roobituk/Blaze/README.md

=========================
Blaze and Blaze IoT/IoT-X
=========================
<p align="center">
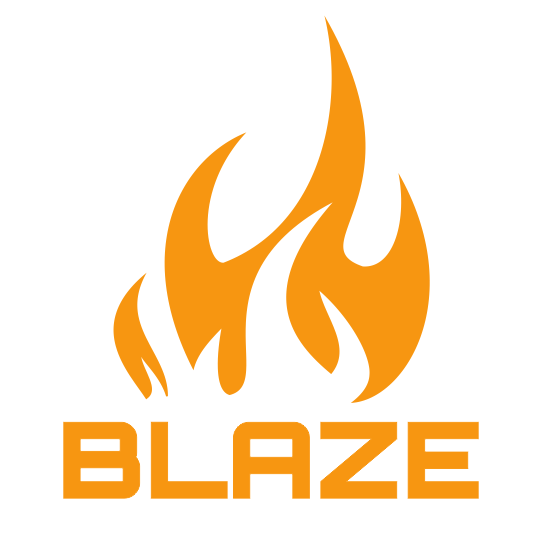
[picture p1: Logos/logo.png]
Blaze Logo
  
</p>

This is the Blaze GitHub repository.

Blaze is very much in the beta stage and is subject to significant changes of the
current code-base and API.

Important components in the Blaze repository:
- Firmware		-- The embedded software running on Blaze
- Hardware		-- Information relating to all Blaze hardware
- Software		-- Software packages and utilities for Blaze
