roobituk/Blaze/Firmware/README.md

=========================
Blaze Firmware
=========================

This is the home for the Blaze firmware.

- Blaze API				-- Contains the C++ API for working with the on-board hardware and peripheral set
- Examples
- Examples/BS			-- Blaze Studio example projects
- Examples/KDS			-- Kinetis Design Studio example projects
