roobituk/Blaze/Firmware/Drivers/README.md

=========================
Blaze Bootloader Drivers
=========================

The CDC.inf file is the Windows driver for the Blaze Bootloader device.

Refer to the cdc.inf_readme.txt for more information and installation instructions.
