roobituk/Blaze/Firmware/Arduino/blaze/ReadMe.txt

==================
BLAZE ARDUINO CORE
==================

Version 0.01a

This is a very early release of the Blaze core for Arduino IDE
