roobituk/Blaze/Firmware/Examples/Arduino/README.md

=========================
Blaze Arduino Examples
=========================

Example sketches for use with Arduino IDE.

Download the Arduino IDE from here:

https://www.arduino.cc/en/main/software

To download any of the Arduino examples to Blaze:

1) Install the Arduino IDE environment<br/>
2) Install the Arduino Blaze Support package<br/>
3) Create a new Sketch<br/>
4) Ensure that the "Blaze" option is selected for "Board" under the "Tools" menu<br/>
5) Verify your Sketch as with usual Arduino applications<br/>
6) Ensure that Blaze is connected via USB and in Bootloader Mode<br/>
7) Upload the Sketch to Blaze using the "Upload" button from the Arduino toolbar
