roobituk/Blaze/Firmware/Examples/Arduino/1. Hello World/README.md

=========================
Blaze Arduino Examples
=========================

#1 Hello World

Displays a simple "hello world" message onto the Blaze display. 

This example is useful because it contains
all of the routines required to start up the microcontroller as well as initializing the TFT display and
its associated peripherals.
