roobituk/Blaze/Firmware/Examples/Arduino/2. Touch Screen/README.md

=========================
Blaze Arduino Examples
=========================

#2 Touch Screen

Uses the touch screen controller to draw a trail beneath the users finger. 

This example demonstrates how to read touch data from the touch controller as well as being
able to draw to a specific location on the display.
