roobituk/Blaze/Firmware/Examples/Arduino/3. Digital/README.md

=========================
Blaze Arduino Examples
=========================

#3 Digital

Toggles and reads various digital IO pins.

This example demonstrates how to use the Arduino API with Blaze to write and read digital IO pins as well
as configure input pins as interrupt sources.
