roobituk/Blaze/Firmware/Examples/Arduino/4. Analog/README.md

=========================
Blaze Arduino Examples
=========================

#4 Analog

Reads from an analog input and writes to the DAC output.

This example demonstrates how to use the Arduino API with Blaze to read an analog value from an ADC as well
as write a digital value to the DAC.
