roobituk/Blaze/Firmware/Examples/Arduino/5. Draw Image/README.md

=========================
Blaze Arduino Examples
=========================

#5 Draw Image

Draws an imported bitmap image onto the display.

The image is converted from a native image format (such as a bmp, png, etc) into a suitable
binary format before being turned into C code by a 3rd party utility.
