roobituk/Blaze/Firmware/Examples/KDS/4. USB/Bitmaps/Earth.jpg

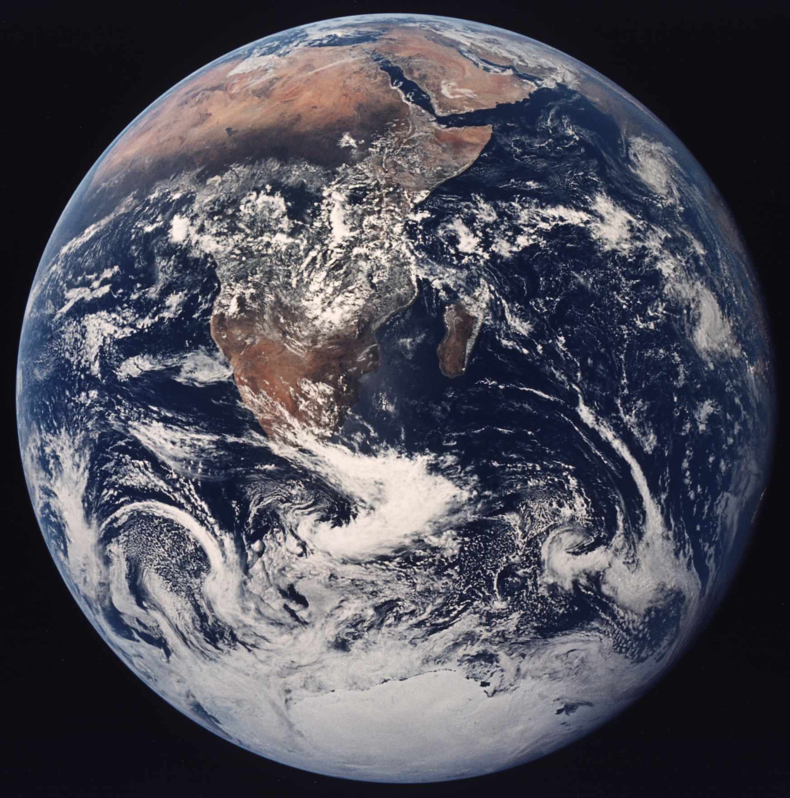
Firmware/Examples/KDS/4. USB/Bitmaps/Earth.jpg
