roobituk/Blaze/Hardware/Blaze_IoT_V1/Bill of Materials.xls

Designator | Description | Comment | Quantity
C1 | CAP CER 10uF 10V X5R 20% 0603 | 10uF/10V | 1
C2, C3, C4, C5, C17 | CAP CER 100nF 16V X7R 10% 0603 | 100nF/16V | 5
C18, C19 | CAP CER 4.7uF 16V X5R 10% 0603 | 4.7uF/16V | 2
FET1, FET2 | MOSFET P-CH 30V 0.61A SOT-23 | IRLML5103PBF | 2
J1, J2 | CON HDR 2.54mm 14POS 1ROW | MC34735 | 2
J3 | CON HDR 2.54mm 2POS 1ROW | S2B-PH-SM4-TB(LF)(SN) | 1
J4 | CON HDR 2.54mm 3POS 1ROW | S3B-PH-SM4-TB(LF)(SN) | 1
MOD1 | MOD WI-FI SMD | ESP-03 | 1
MOD2 | MOD BLUETOOTH 4.0 SMD | HM-11 | 1
R1, R2 | RES 1K 1% 0603 | 1K | 2
R5 | RES 39K 1% 0603 | 39K | 1
R6 | RES 62K 1% 0603 | 62K | 1
R7, R8 | RES 0R 1% 0603 | 0R | 2
R9, R10 | RES 10K 1% 0603 | 10K | 2
R11 | RES 2k 1% 0603 | 2K | 1
U1 | IC IMU ACC MAG GYRO LGA-24L | LSM9DS1 | 1
U6 | IC MUX QUAD 4BIT 1:2 FET QFN-16 | SN74CBTLV3257RSVR | 1
U7 | IC LI-ION CHARGE CTRL SOT23-5 | MCP73832T-2ACI/OT | 1
 |  |  | 28
