roobituk/Blaze/Hardware/Blaze_IoTX_V1/Bill of Materials.xls

Designator | Description | Comment | Quantity
ANT1 | ANT CHIP GPS GLONASS 1.5x3.0mm | ACA-106-T | 1
C1 | CAP CER 10uF 10V X5R 20% 0603 | 10uF/10V | 1
C2, C3, C4, C5, C17 | CAP CER 100nF 16V X7R 10% 0603 | 100nF/16V | 5
C6 | CAP CER 33nF 50V X7R 10% 0402 | 33nF/50V | 1
C7 | CAP CER 39pF 50V C0G NP0 5% 0402 | 39pF/50V | 1
C8 | CAP CER 470pF 50V X7R 10% 0402 | 470pF/50V | 1
C9 | CAP CER 100pF 50V C0G NP0 5% 0603 | 100pF/50V | 1
C10, C11 | CAP CER 100nF 50V X5R 10% 0402 | 100nF/50V | 2
C18, C19 | CAP CER 4.7uF 16V X5R 10% 0603 | 4.7uF/16V | 2
FET1, FET2, FET3 | MOSFET P-CH 30V 0.61A SOT-23 | IRLML5103PBF | 3
J1, J2 | CON HDR 2.54mm 14POS 1ROW | MC34735 | 2
J3 | CON HDR 2.54mm 2POS 1ROW | S2B-PH-SM4-TB(LF)(SN) | 1
J4 | CON HDR 2.54mm 3POS 1ROW | S3B-PH-SM4-TB(LF)(SN) | 1
L1 | FERRITE BEAD 300R 0.50A 0603 | MMZ1608S301A | 1
L2 | IND HIGH FREQ 6.8nH 0.7A 0402 | 6.8nH/0.7A | 1
L3 | IND HIGH FREQ 5.1nH 0.6A 0402 | DNF | 1
MOD1 | MOD WI-FI SMD | ESP-03 | 1
MOD2 | MOD BLUETOOTH 4.0 SMD | HM-11 | 1
R1, R2 | RES 1K 1% 0603 | 1K | 2
R3, R4 | RES 0R 1% 0402 | 0R | 2
R5 | RES 39K 1% 0603 | 39K | 1
R6 | RES 62K 1% 0603 | 62K | 1
R7, R8 | RES 0R 1% 0603 | 0R | 2
R9, R10, R12 | RES 10K 1% 0603 | 10K | 3
R11 | RES 2k 1% 0603 | 2K | 1
U1 | IC IMU ACC MAG GYRO LGA-24L | LSM9DS1 | 1
U2 | IC LNA GPS GALILEO GLONASS UDFN-6 | MAX2659ELT+ | 1
U3 | IC FLT SAW GPS GLONASS 1.4x1.1mm | SF14-1582M5UUD2 | 1
U4 | IC GPS GNSS LGA-43 | EVA-7M-0 | 1
U6 | IC MUX QUAD 4BIT 1:2 FET QFN-16 | SN74CBTLV3257RSVR | 1
U7 | IC LI-ION CHARGE CTRL SOT23-5 | MCP73832T-2ACI/OT | 1
 |  |  | 45
