roobituk/Blaze/Hardware/Blaze_V1/Bill of Materials.xls

Designator | Description | Comment | Quantity
C1, C3, C4 | CAP CER 4.7uF 16V X5R 10% 0603 | 4.7uF/16V | 2
C5 | CAP CER 470nF 50V X7R 10% 0805 | 470nF/50V | 1
C6 | CAP CER 10uF 10V X5R 20% 0603 | 10uF/10V | 1
C2, C7, C8, C9, C13, C14, C17 | CAP CER 100nF 16V X7R 10% 0603 | 100nF/16V | 6
C15, C16 | CAP CER 22uF 6.3V X5R 20% 0805 | 22uF/6.3V | 2
D1 | DIODE ESD 4-CH SOT23-6 | TPD4S009DBVR | 1
D2 | DIODE SCHOTTKY 20V 0.5A SOD-123 | MBR0520L | 1
D3 | DIODE SCHOTTKY 30V 0.2A SOT23-3 | BAT54S | 1
FET1 | MOSFET P-CH 20V 4.30A SOT23-3 | PMV65XP | 1
J1 | CON RCPT MICRO USB B SMT | USB3065-30-A | 1
J2 | CON RCPT 0.40mm 24POS | DF37NB-24DS-0.4V | 1
J3 | CON RCPT 0.40mm 10POS | DF37NB-10DS-0.4V | 1
J4 | CON SKT MICRO SD SMT | DM3CS-SF | 1
L1 | FERRITE BEAD 300R 0.50A 0603 | MMZ1608S301A | 1
L2 | IND POWER 4.7uH 1.4A 20% SMD | 4.7uH/1.4A | 1
L3 | IND POWER 10uH 1.0A 20% SMD | 10uH/1.0A | 1
LED1 | LED GREEN 12MCD 568NM 0805 | KPT-2012SGC | 1
R1, R2 | RES 33R 1% 0603 | 33R | 2
R3, R7 | RES 10K 1% 0603 | 10K | 2
R4 | RES 5R6 1% 0805 | 5R6 | 1
R6, R8, R9, R10 | RES 1K 1% 0603 | 1K | 4
R11 | RES 100K 1% 0603 |  | 1
U1 | IC REG SYNC BUCK 3.3V 0.50A SOT23-5 | MCP1603T-330I/OS | 1
U2 | IC REG SERIAL LED SOT23-5 | FAN5333BSX | 1
U3 | IC MCU 120MHz ARM LQFP-64 | MK22FN1M0VLH12 | 1
X1 | CRYSTAL 16MHz 9pF TSX-3225 | 16MHz | 1
X2 | CRYSTAL 32.768kHz 9pF FC-135 | 32.768kHz | 1
Z1 | DIODE ZENER 24V 0.25A SOT23-3 | BZX84C24 | 1
 |  |  | 40
