roobituk/Blaze/Hardware/Blaze_V1/Schematics - Mod A.pdf

# V1 - Blaze

# USB Micro Receptacle

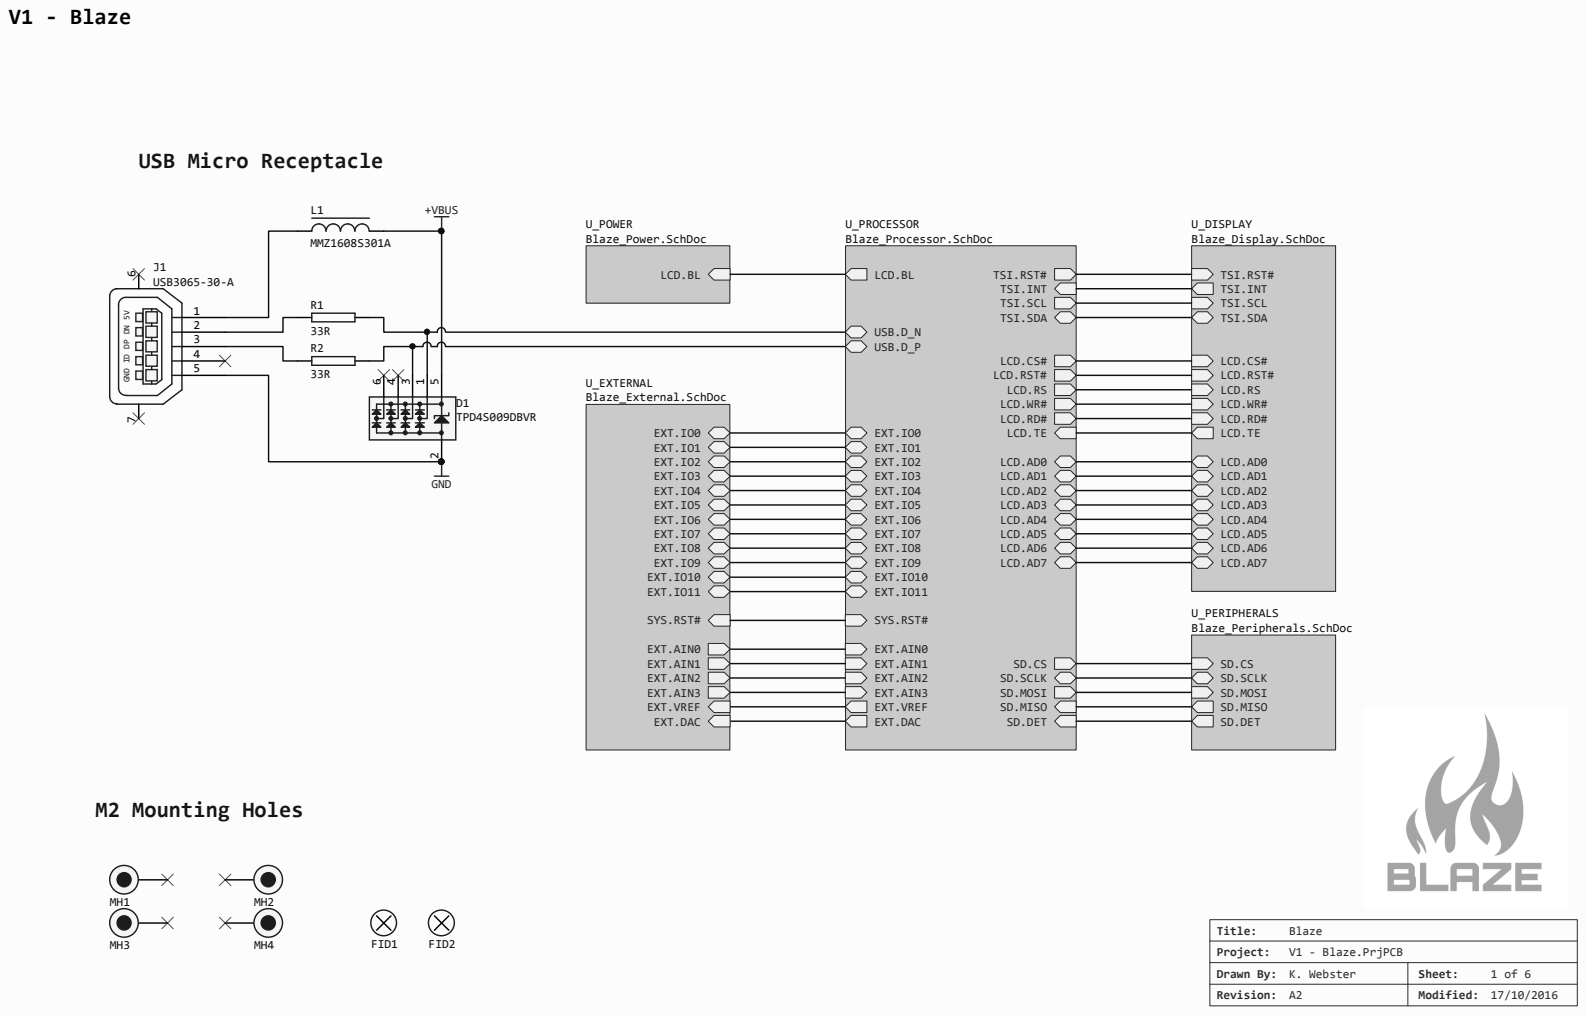
[picture p7: page 1]
Title:; Blaze; Project:; V1 - Blaze.PrjPCB; Revision: A2; Modified: 17/10/2016; Sheet:; LCD.BL; U_POWER Blaze_Power.SchDoc; TSI.RST# TSI.INT TSI.SCL TSI.SDA; LCD.TE; LCD.CS#; LCD.RS; LCD.RST#; LCD.RD#; LCD.WR#; LCD.AD0 LCD.AD1 LCD.AD2 LCD.AD3 LCD.AD4 LCD.AD5 LCD.AD6 LCD.AD7; USB.D_P; USB.D_N; EXT.DAC; EXT.IO0 EXT.IO1 EXT.IO2 EXT.IO3 EXT.IO4 EXT.IO5 EXT.IO6 EXT.IO7 EXT.IO8 EXT.IO9 EXT.IO10 EXT.IO11; EXT.AIN0 EXT.AIN1 EXT.AIN2 EXT.AIN3 EXT.VREF; SD.CS SD.SCLK SD.MOSI SD.MISO SD.DET; SYS.RST#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

Drawn By: K. Webster

# V1 - Blaze

# Voltage Regulator

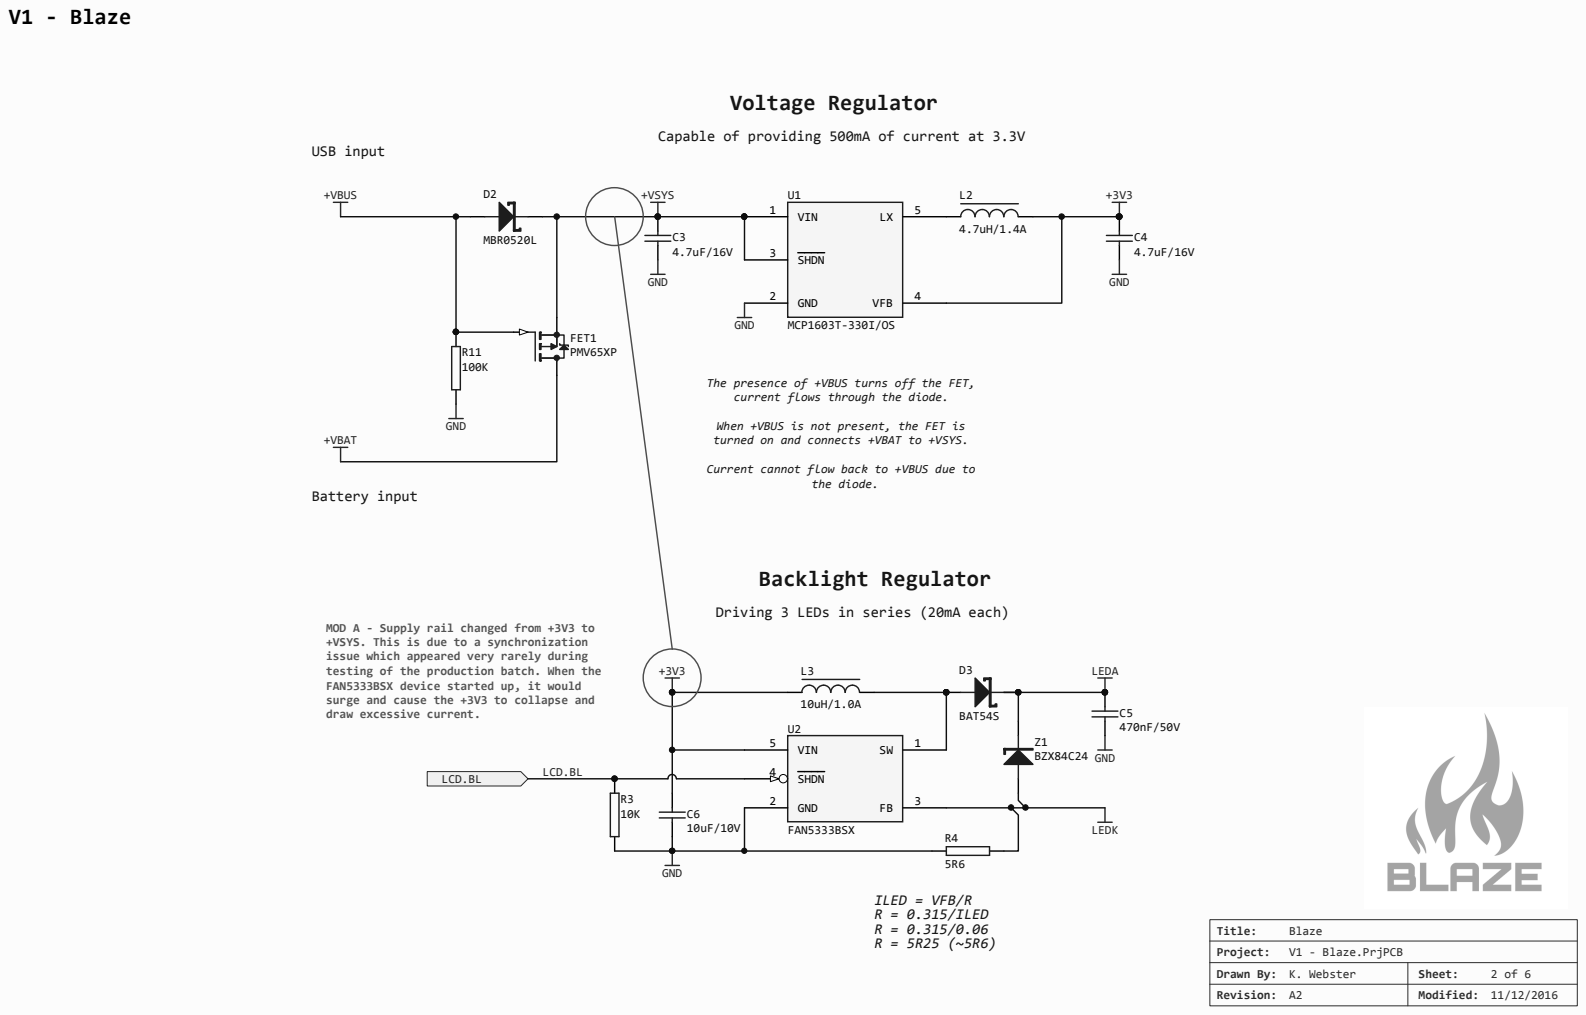
[picture p8: page 2]

Capable of providing 500mA of current at 3.3V

The presence of +VBUS turns off the FET,
current flows through the diode.

When +VBUS is not present, the FET is
turned on and connects +VBAT to +VSYS.

Current cannot flow back to +VBUS due to

Driving 3 LEDs in series (20mA each)

MOD A - Supply rail changed from +3V3 to
+VSYS. This is due to a synchronization
issue which appeared very rarely during
testing of the production batch. When the
FAN5333BSX device started up, it would
surge and cause the +3V3 to collapse and
draw excessive current.

# V1 - Blaze Kinetis K22 120MHz Cortex-M4 Microcontroller

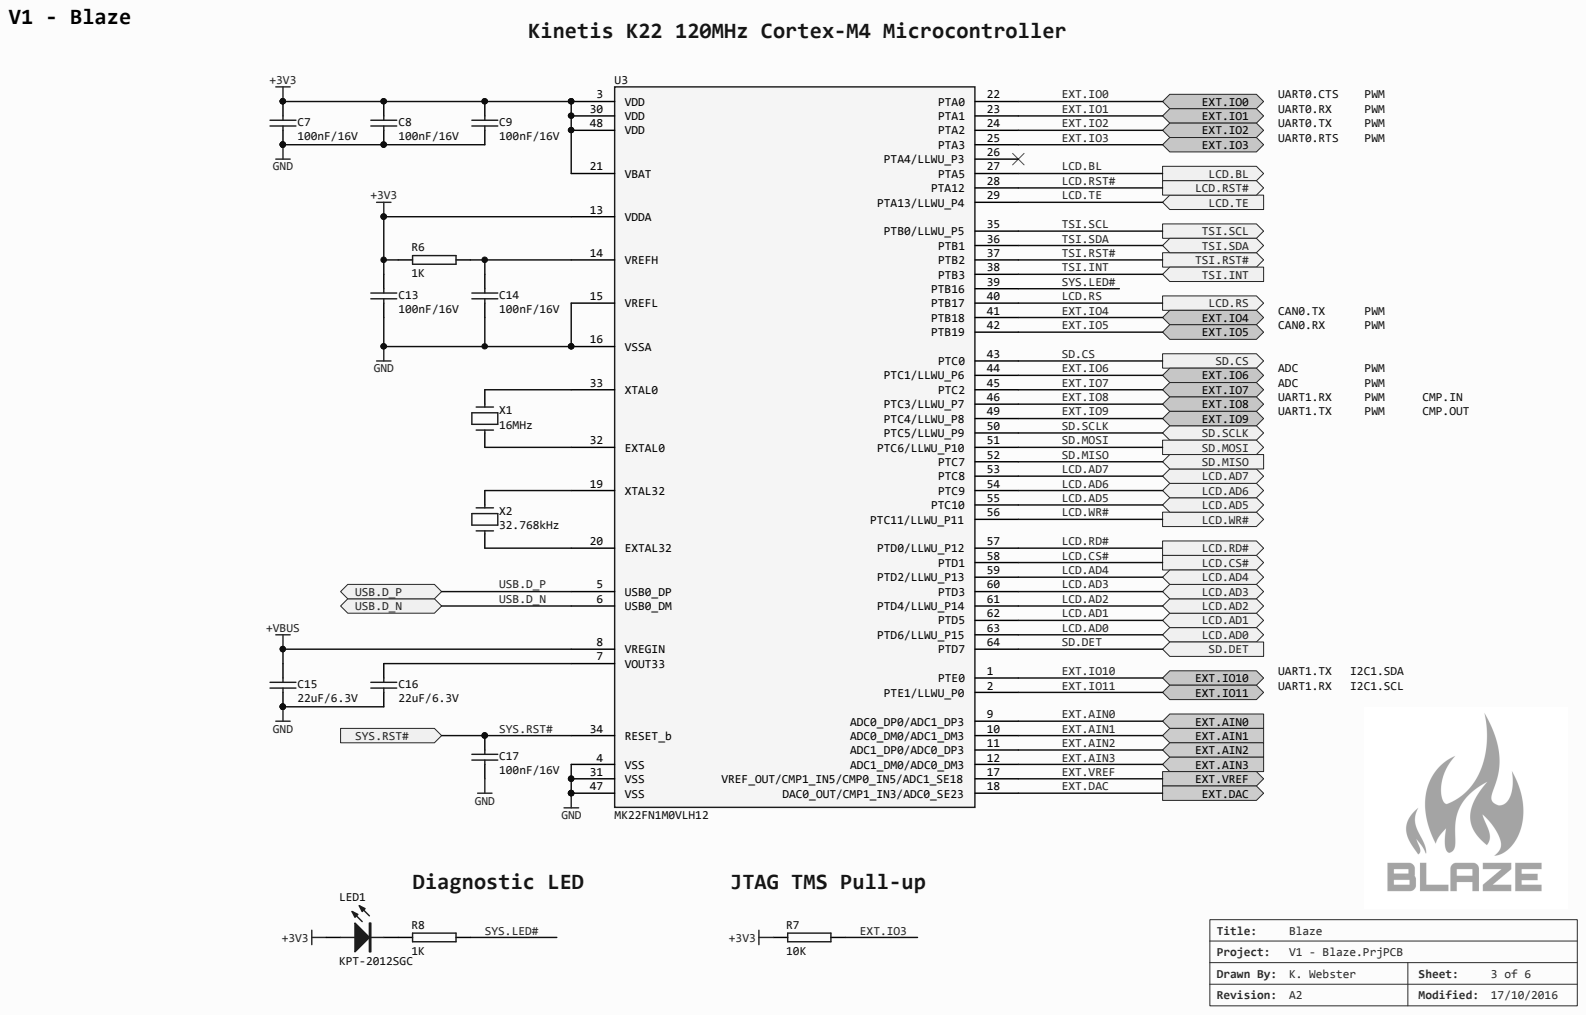
[picture p9: page 3]

JTAG TMS Pull-up

# V1 - Blaze

# 1.6" 240x240px Display

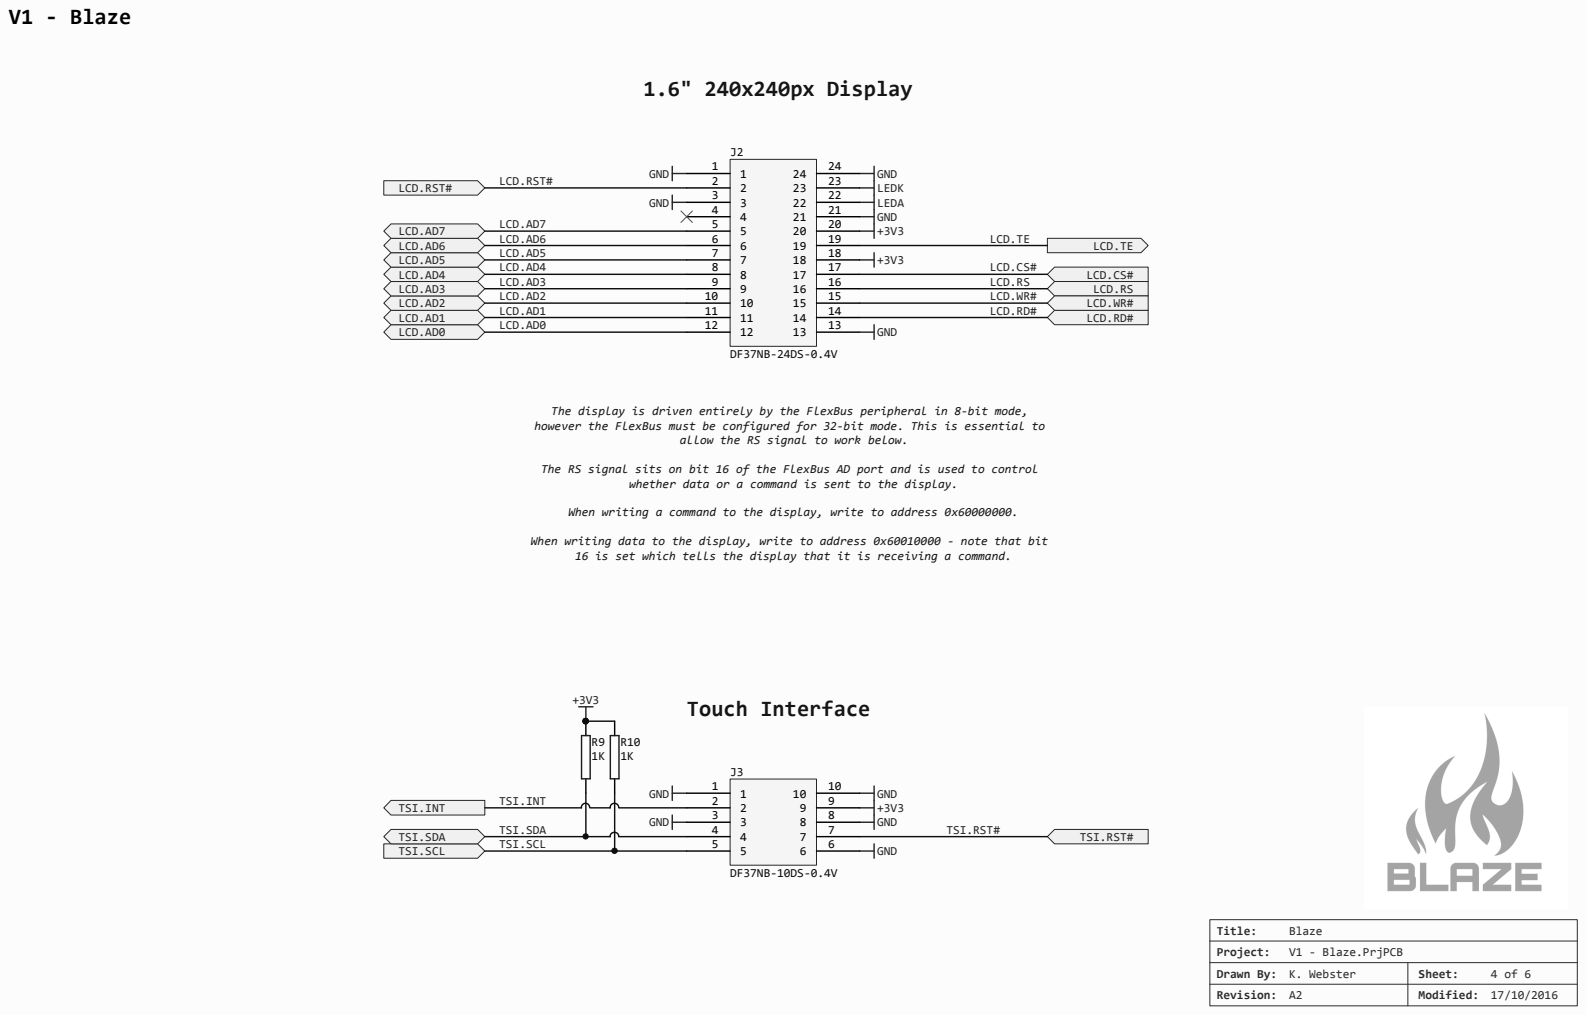
[picture p10: page 4]
Title:; Blaze; Project:; V1 - Blaze.PrjPCB; Revision: A2; Modified: 17/10/2016; Sheet:; GND; LCD.AD0; LCD.AD1; LCD.AD2; LCD.AD3; LCD.AD4; LCD.AD5; LCD.AD6; LCD.AD7; LCD.RD#; LCD.WR#; LCD.RS; LCD.CS# +3V3; LCD.TE +3V3; LEDA; LEDK; TSI.INT; TSI.SDA TSI.SCL; TSI.RST#; Touch Interface; TSI.SCL; TSI.SDA; LCD.TE; LCD.CS# LCD.RS; LCD.RST#

GND LCD.RST#

The display is driven entirely by the FlexBus peripheral in 8-bit mode,
however the FlexBus must be configured for 32-bit mode. This is essential to

allow the RS signal to work below.

The RS signal sits on bit 16 of the FlexBus AD port and is used to control

whether data or a command is sent to the display.

When writing a command to the display, write to address 0x60000000.

When writing data to the display, write to address 0x60010000 - note that bit

16 is set which tells the display that it is receiving a command.

Drawn By: K. Webster

# V1 - Blaze

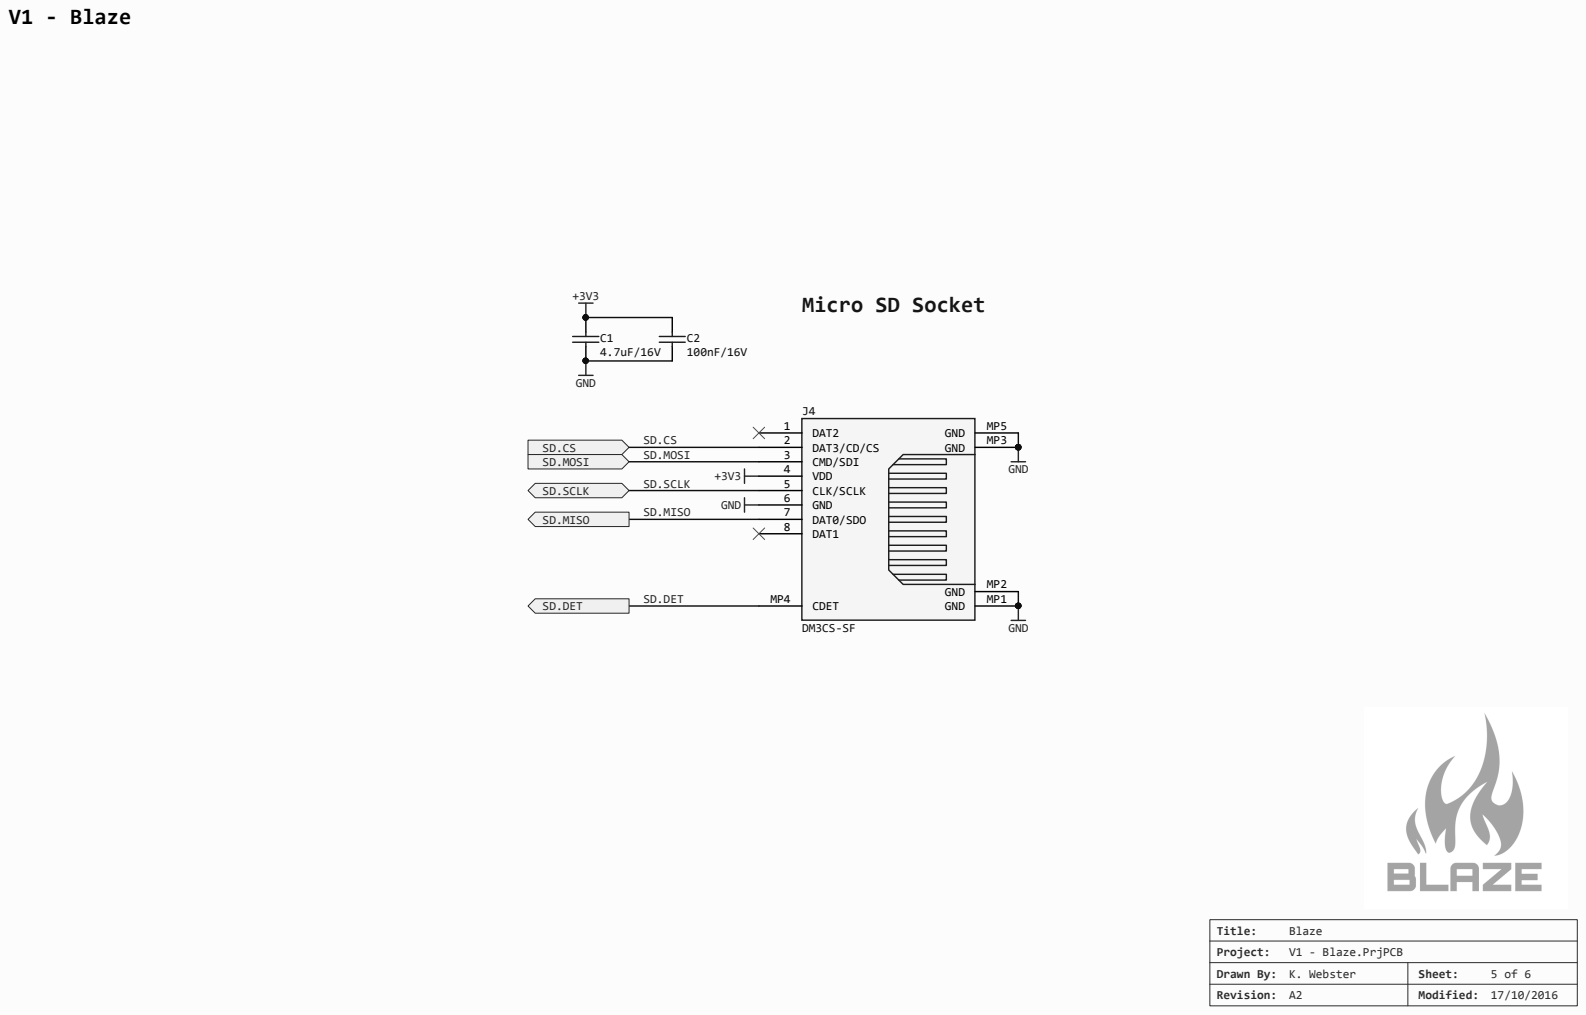
[picture p11: page 5]
Title:; Blaze; Project:; V1 - Blaze.PrjPCB; Revision: A2; Modified: 17/10/2016; Sheet:; GND; DAT3/CD/CS 2 CMD/SDI 3 VDD 4 CLK/SCLK 5 GND 6 DAT0/SDO 7 DAT1 8; DAT2 1; CDET MP4; SD.MISO; SD.SCLK; SD.DET

Micro SD Socket

SD.MOSI SD.CS
SD.MOSI

Drawn By: K. Webster

# V1 - Blaze

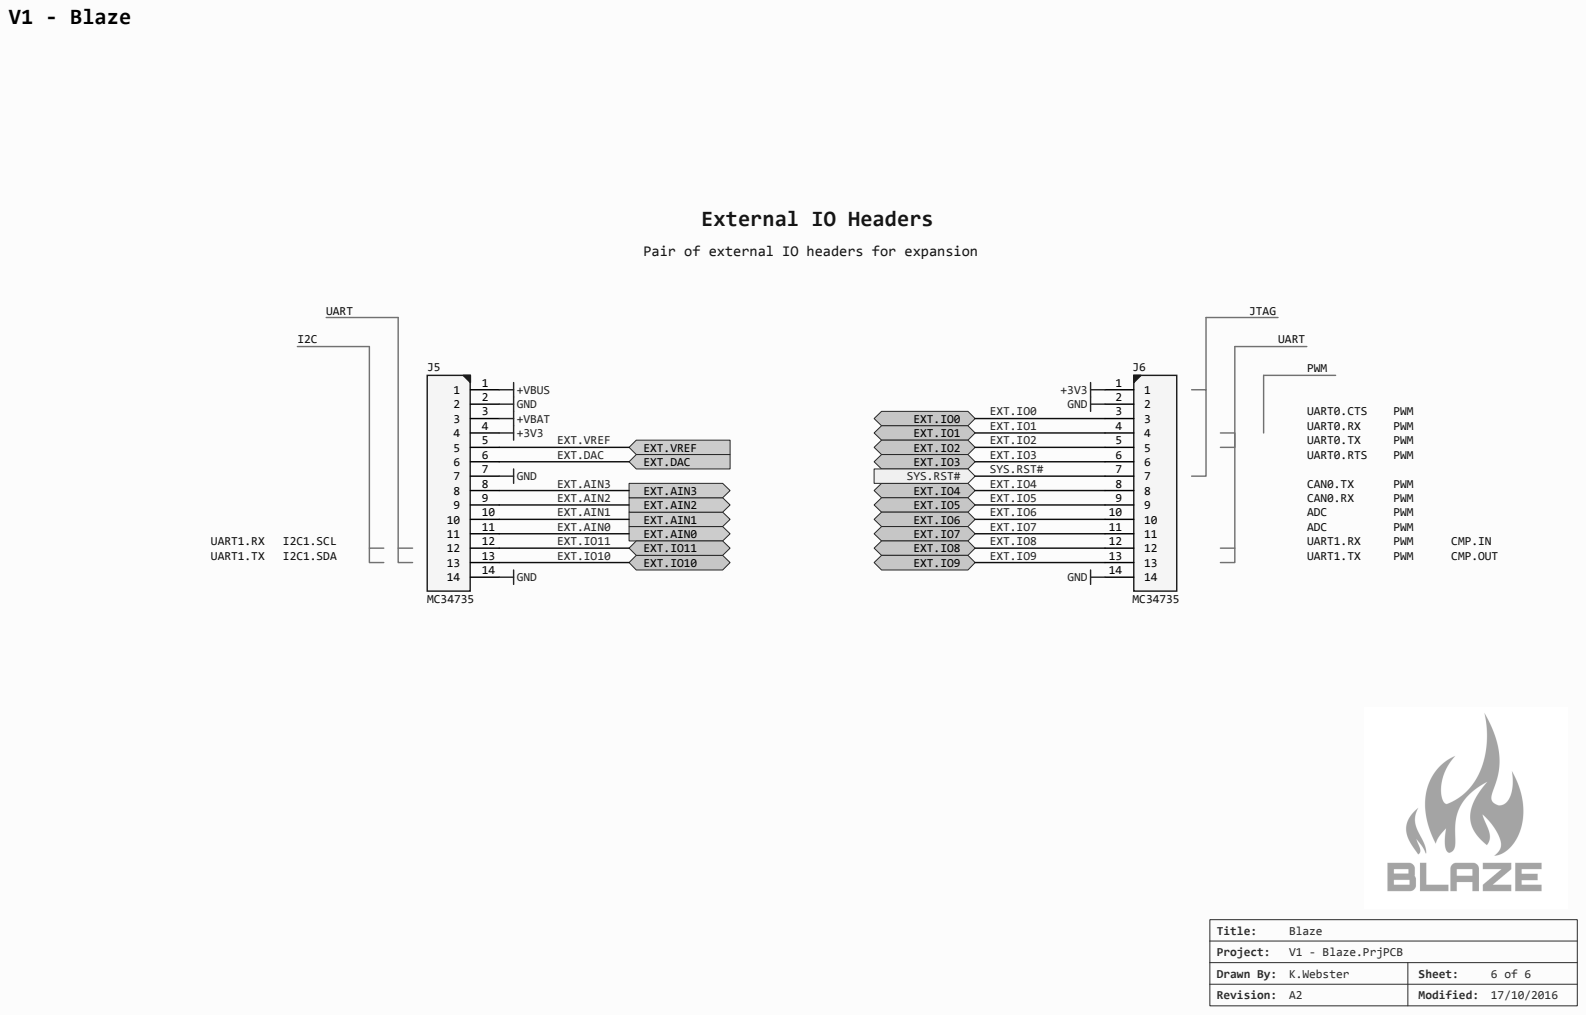
[picture p12: page 6]
Title:; Blaze; Project:; V1 - Blaze.PrjPCB; Revision: A2; Modified: 17/10/2016; Sheet:; EXT.VREF EXT.DAC; EXT.AIN0; EXT.AIN1; EXT.AIN2; EXT.AIN3; EXT.IO0 EXT.IO1 EXT.IO2 EXT.IO3; EXT.IO4 EXT.IO5 EXT.IO6 EXT.IO7 EXT.IO8; EXT.IO10; EXT.IO9; EXT.IO11; SYS.RST#; JTAG; UART; PWM; +VBUS GND; GND; +VBAT +3V3; +3V3 GND; UART0.RX UART0.TX; UART0.CTS; UART0.RTS; PWM PWM PWM PWM; CAN0.TX CAN0.RX; PWM PWM; ADC ADC; UART1.TX; UART1.RX; CMP.IN CMP.OUT; UART1.RX UART1.TX; I2C1.SCL I2C1.SDA

External IO Headers

Pair of external IO headers for expansion

Drawn By: K.Webster
