roobituk/Blaze/Hardware/Blaze_IoT_V1/Schematics.pdf

# V1 - Blaze IoT/IoT-X

J1

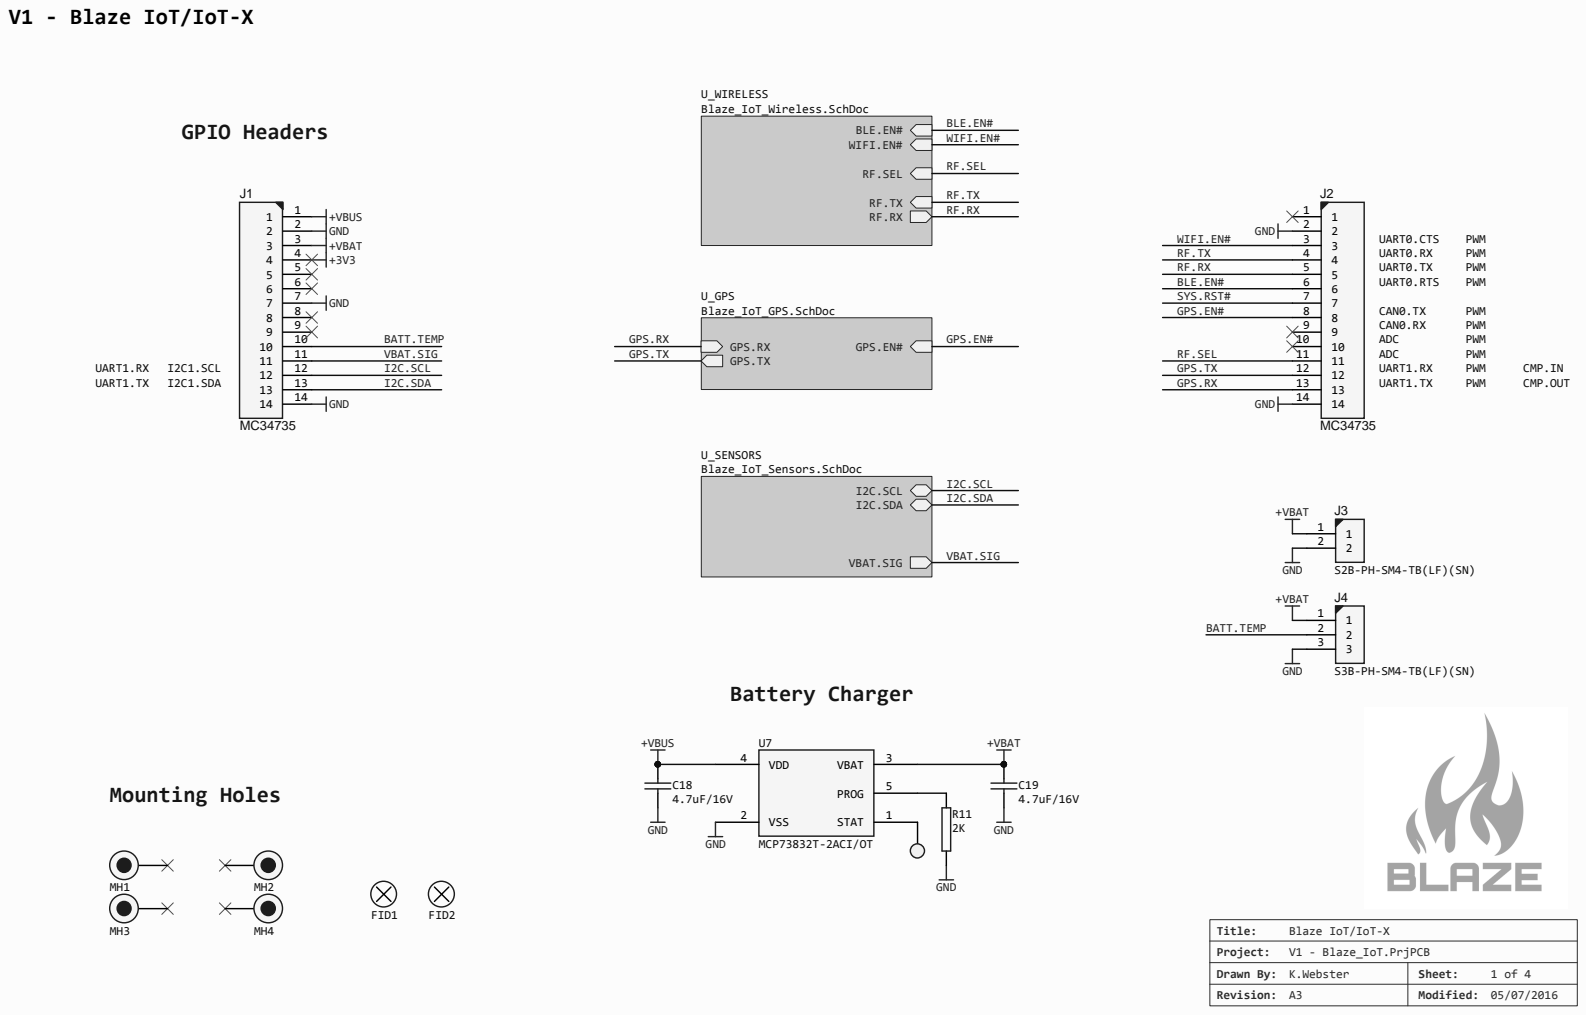
[picture p13: page 1]
Title:; Blaze IoT/IoT-X; Project:; V1 - Blaze_IoT.PrjPCB; Revision: A3; Modified: 05/07/2016; Sheet:; GPS.TX GPS.RX; WIFI.EN#; BLE.EN#; RF.SEL; SYS.RST#; GPIO Headers; I2C.SDA; I2C.SCL; VBAT.SIG; BLE.EN# WIFI.EN#; U_WIRELESS Blaze_IoT_Wireless.SchDoc; GPS.EN#; GPS.TX; GPS.RX; U_GPS Blaze_IoT_GPS.SchDoc; I2C.SCL I2C.SDA; U_SENSORS Blaze_IoT_Sensors.SchDoc; VBAT; PROG; STAT; VDD 4; VSS 2; GND; MCP73832T-2ACI/OT; +VBUS; +VBAT; FID1; FID2; BATT.TEMP; Mounting Holes; Battery Charger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

Drawn By: K.Webster

# V1 - Blaze IoT/IoT-X

# ESP8266-03 Wi-Fi Module

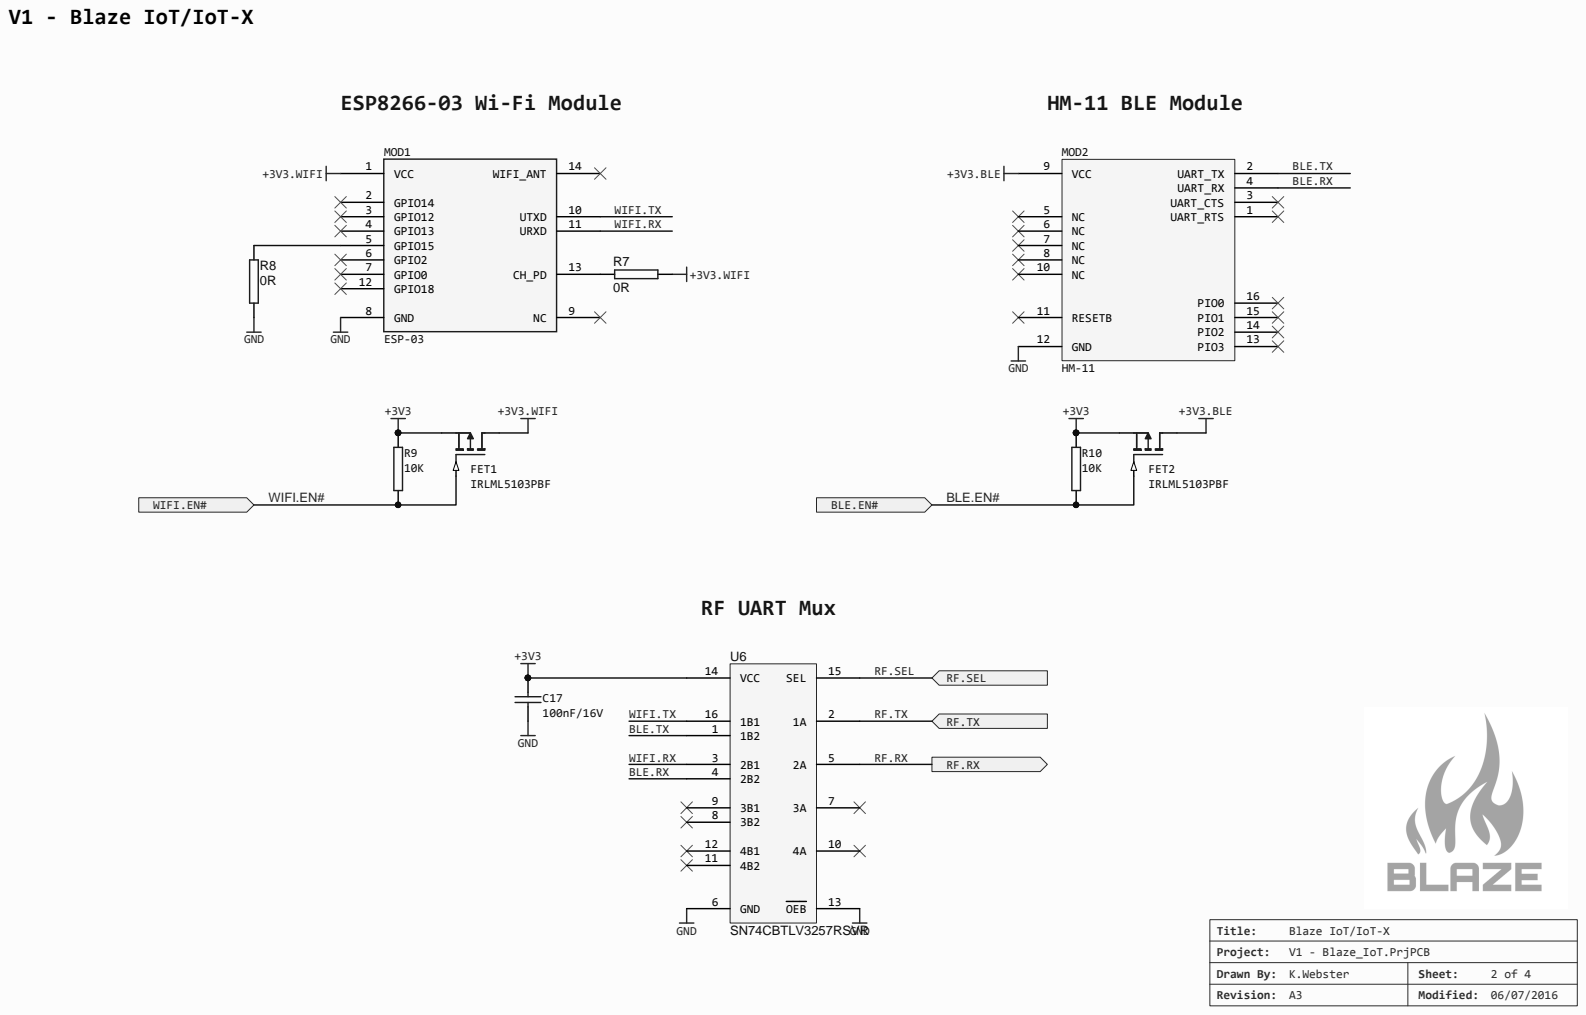
[picture p14: page 2]
Title:; Blaze IoT/IoT-X; Project:; V1 - Blaze_IoT.PrjPCB; Revision: A3; Modified: 06/07/2016; Sheet:; UTXD; URXD; WIFI_ANT; 14 VCC 1; GPIO14 2 GPIO12 3 GPIO13 4 GPIO15 5 GPIO2 6 GPIO0 7; GND 8; GPIO18 12; MOD1; ESP-03; WIFI.TX WIFI.RX; GND; +3V3.WIFI; WIFI.EN#; BLE.TX; BLE.RX UART_TX; 2 UART_RX; UART_CTS; UART_RTS; PIO0; PIO1; PIO2; PIO3; RESETB 11; VCC 9; GND 12; MOD2; BLE.EN#; +3V3.BLE; RF.SEL; BLE.RX; WIFI.TX; WIFI.RX; FET1 IRLML5103PBF; FET2 IRLML5103PBF; GND 6; OEB; VCC 14; SEL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

HM-11 BLE Module

RF UART Mux

Drawn By: K.Webster

# V1 - Blaze IoT/IoT-X

C6

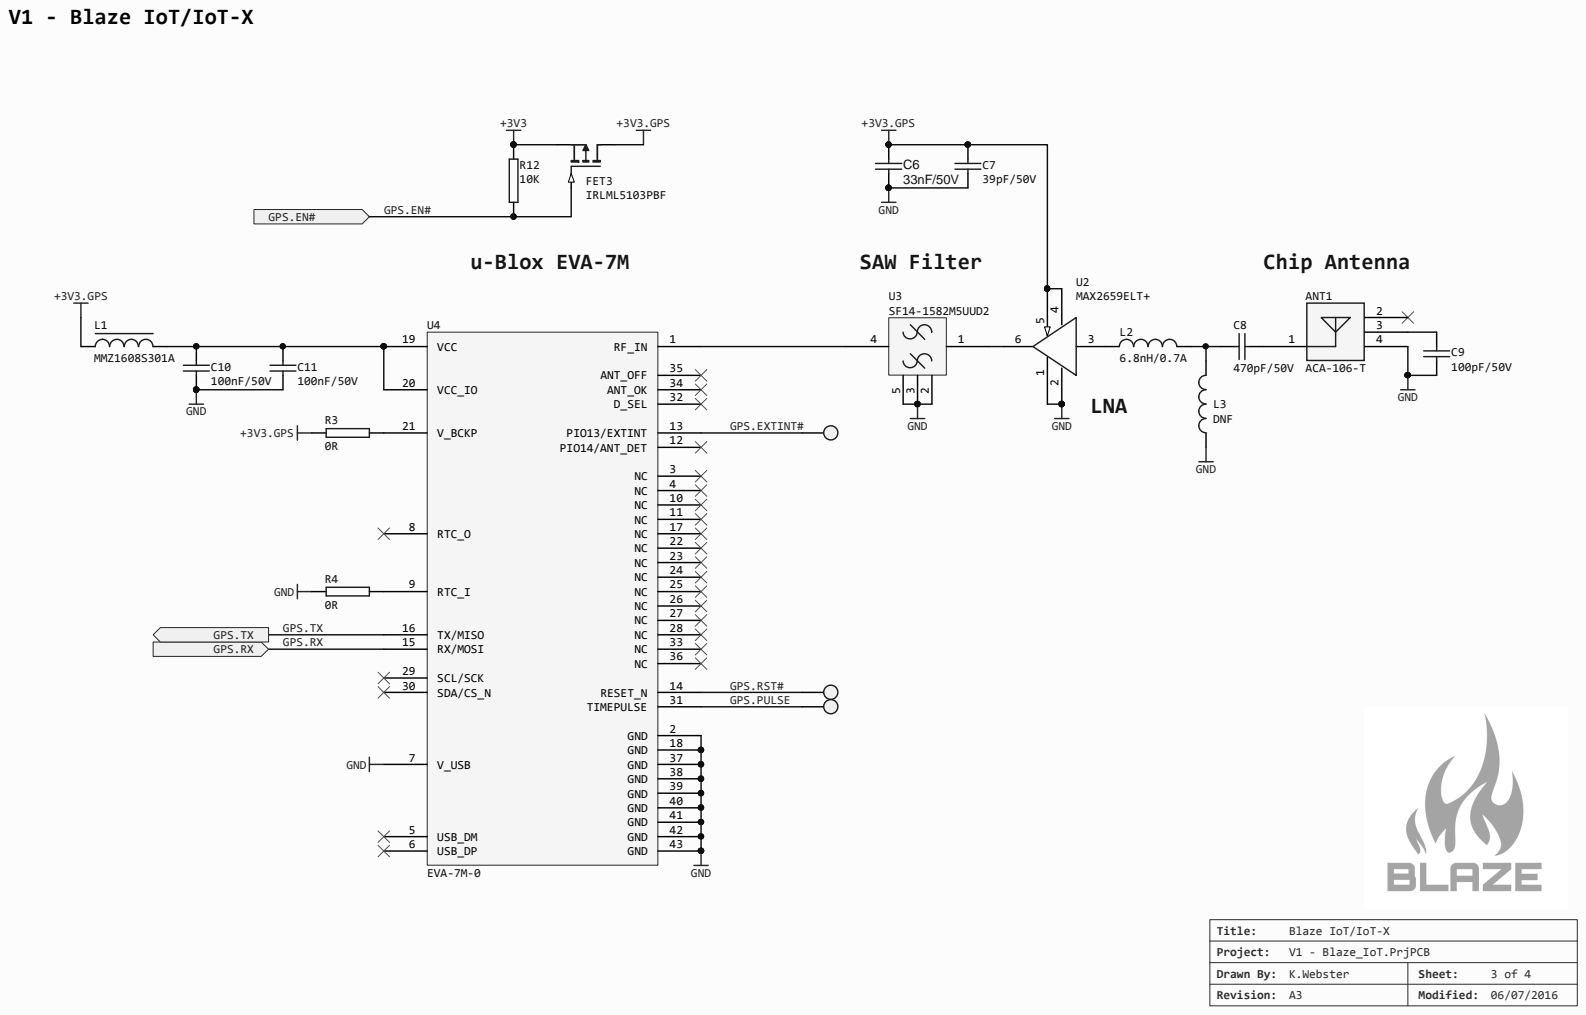
[picture p15: page 3]

# V1 - Blaze IoT/IoT-X

# ST LSM9DS1 IMU Sensor

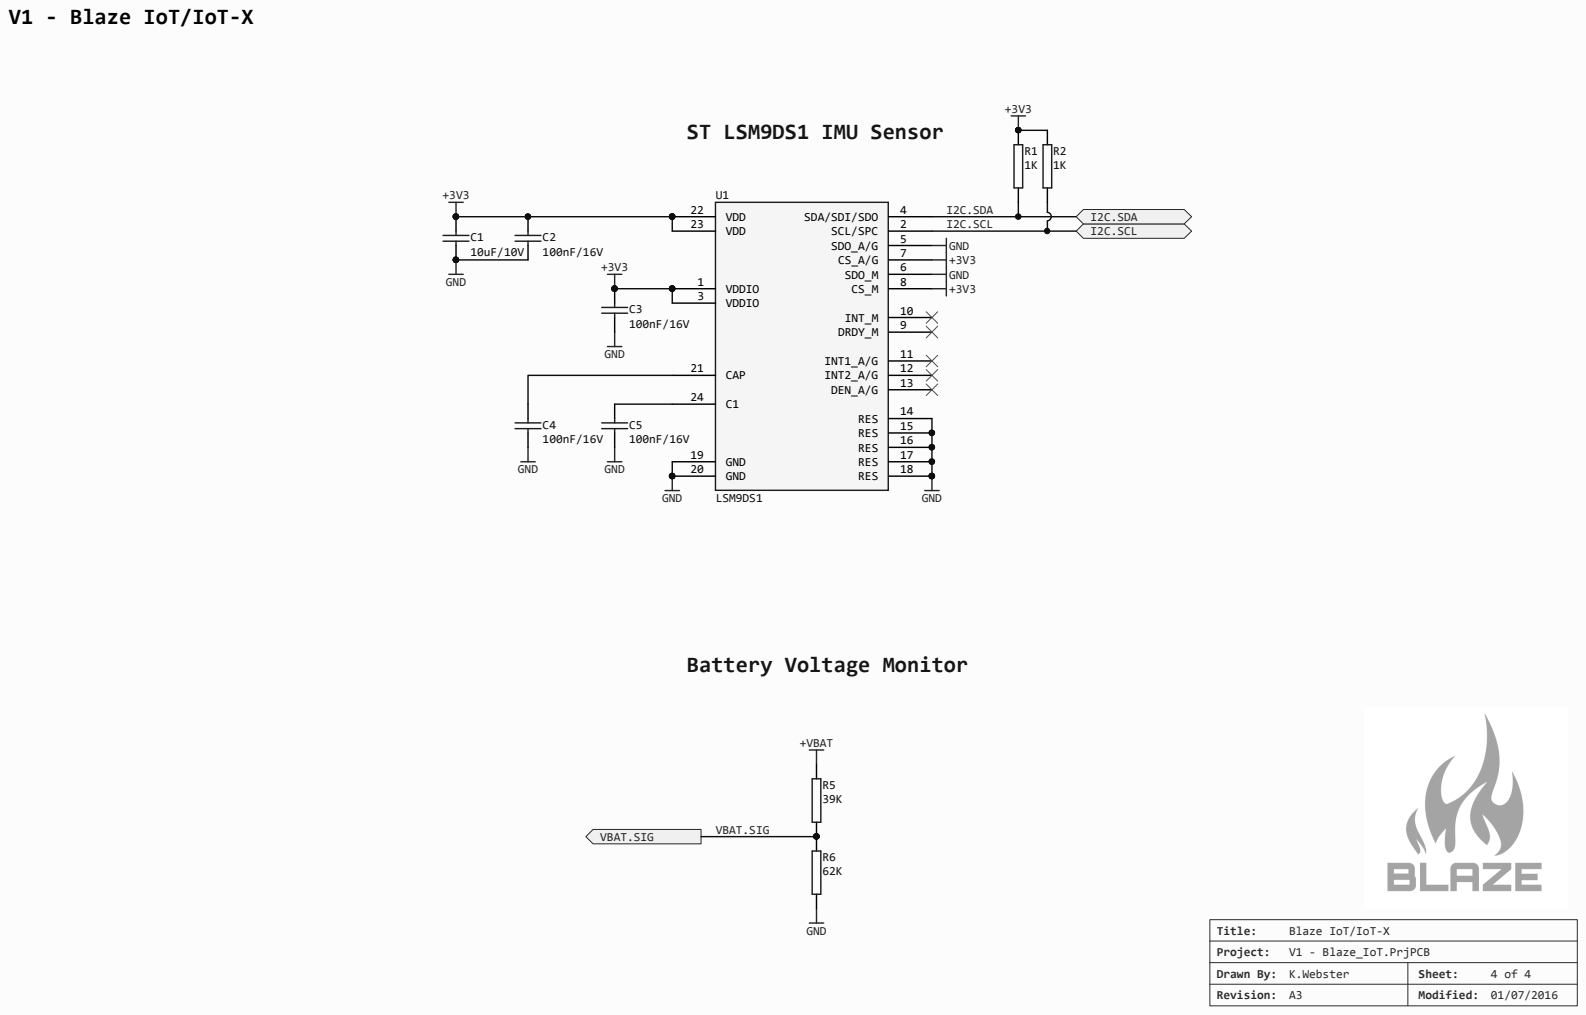
[picture p16: page 4]

VBAT.SIG
