roobituk/Blaze/Firmware/Arduino/blaze/Pins_Blaze.h

#ifndef PINS_BLAZE_H
#define PINS_BLAZE_H

// Number of available digital and analog pins
#define NUM_DIGITAL_PINS            12
#define NUM_ANALOG_INPUTS           4
#define NUM_ANALOG_OUTPUTS			1

// MK22FN1M0 pin mapping
#define PTA0		0				// EXT.IO0
#define PTA1		1				// EXT.IO1
#define PTA2		2				// EXT.IO2
#define PTA3		3				// EXT.IO3

#define PTB18		18				// EXT.IO4
#define PTB19		19				// EXT.IO5

#define PTC1		1				// EXT.IO6
#define PTC2		2				// EXT.IO7
#define PTC3		3				// EXT.IO8
#define PTC4		4				// EXT.IO9

#define PTE0		0				// EXT.IO10
#define PTE1		1				// EXT.IO11

#define ADC0		9				// EXT.AIN0
#define ADC1		10				// EXT.AIN1
#define ADC2		11				// EXT.AIN2
#define ADC3		12				// EXT.AIN3

#define VREF		17				// EXT.VREF
	
#define DAC0		18				// EXT.DAC


// Pin definitions for Blaze
#define A0
#define A1
#define A2


#define D0
#define D1
#define D2
#define D3
#define D4
#define D5
#define D6
#define D7


#endif
