roobituk/Blaze/Firmware/Arduino/blaze/Colours.cpp

#include "Colours.h"

/*!-----------------------------------------------------------------------------

*/
Colour Colours::AliceBlue(void) {

}

/*!-----------------------------------------------------------------------------

*/
Colour Colours::AntiqueWhite(void) {

}

/*!-----------------------------------------------------------------------------

*/
Colour Colours::Aqua(void) {

}

/*!-----------------------------------------------------------------------------

*/
Colour Colours::Aquamarine(void) {

}

/*!-----------------------------------------------------------------------------

*/
Colour Colours::Azure(void) {

}

/*!-----------------------------------------------------------------------------

*/
Colour Colours::Beige(void) {

}

/*!-----------------------------------------------------------------------------

*/
Colour Colours::Bisque(void) {

}

/*!-----------------------------------------------------------------------------

*/
Colour Colours::Black(void) {
	return Colour(0x00000000);
}

/*!-----------------------------------------------------------------------------

*/
Colour Colours::BlanchedAlmond(void) {

}

/*!-----------------------------------------------------------------------------

*/
Colour Colours::Blue(void) {

}

/*!-----------------------------------------------------------------------------

*/
Colour Colours::BlueViolet(void) {

}

/*!-----------------------------------------------------------------------------

*/
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

*/
Colour Colours::SandyBrown(void) {

}

/*!-----------------------------------------------------------------------------

*/
Colour Colours::SeaGreen(void) {

}

/*!-----------------------------------------------------------------------------

*/
Colour Colours::Seashell(void) {

}

/*!-----------------------------------------------------------------------------

*/
Colour Colours::Sienna(void) {

}

/*!-----------------------------------------------------------------------------

*/
Colour Colours::Silver(void) {

}

/*!-----------------------------------------------------------------------------

*/
Colour Colours::SkyBlue(void) {

}

/*!-----------------------------------------------------------------------------

*/
Colour Colours::SlateBlue(void) {

}

/*!-----------------------------------------------------------------------------

*/
Colour Colours::SlateGray(void) {

}

/*!-----------------------------------------------------------------------------

*/
Colour Colours::Snow(void) {

}

/*!-----------------------------------------------------------------------------

*/
Colour Colours::SpringGreen(void) {

}

/*!-----------------------------------------------------------------------------

*/
Colour Colours::SteelBlue(void) {

}

/*!-----------------------------------------------------------------------------

*/
Colour Colours::Tan(void) {

}

/*!-----------------------------------------------------------------------------

*/
Colour Colours::Teal(void) {

}

/*!-----------------------------------------------------------------------------

*/
Colour Colours::Thistle(void) {

}

/*!-----------------------------------------------------------------------------

*/
Colour Colours::Tomato(void) {

}

/*!-----------------------------------------------------------------------------

*/
Colour Colours::Turquoise(void) {

}

/*!-----------------------------------------------------------------------------

*/
Colour Colours::Violet(void) {

}

/*!-----------------------------------------------------------------------------

*/
Colour Colours::Wheat(void) {

}

/*!-----------------------------------------------------------------------------

*/
Colour Colours::White(void) {
	return Colour(0x00FFFFFF);
}

/*!-----------------------------------------------------------------------------

*/
Colour Colours::WhiteSmoke(void) {

}

/*!-----------------------------------------------------------------------------

*/
Colour Colours::Yellow(void) {

}

/*!-----------------------------------------------------------------------------

*/
Colour Colours::YellowGreen(void) {

}

/*!-----------------------------------------------------------------------------

*/
/*
Colour Colours::FromArgb(int32_t a, int32_t r, int32_t g, int32_t b) {

	return Colour((a << 24) | (r << 16) | (g << 8) | b);

}*/

/*!-----------------------------------------------------------------------------

*/
/*
uint16_t Colours::To16bit(Colour c) {

	return (uint16_t)(((c.value & 0x00F80000) >> 8) | ((c.value & 0x0000FC00) >> 5) | ((c.value & 0x000000F8) >> 3));

}*/


/*!-----------------------------------------------------------------------------

*/
/*
uint16_t Colours::To16bit(int32_t a, int32_t r, int32_t g, int32_t b) {

	return (int16_t)(((r / 8) << 11) + ((g / 4) << 5) + (b / 8));

}*/
