roobituk/Blaze/Firmware/Arduino/blaze/Colours.h

#ifndef ColourS_HPP
#define ColourS_HPP

#include "Common.h"

/*!-----------------------------------------------------------------------------

*/
class Colours {

	public:

		static Colour AliceBlue(void);
		static Colour AntiqueWhite(void);
		static Colour Aqua(void);
		static Colour Aquamarine(void);
		static Colour Azure(void);
		static Colour Beige(void);
		static Colour Bisque(void);
		static Colour Black(void);
		static Colour BlanchedAlmond(void);
		static Colour Blue(void);
		static Colour BlueViolet(void);
		static Colour Brown(void);
		static Colour BurlyWood(void);
		static Colour CadetBlue(void);
		static Colour Chartreuse(void);
		static Colour Chocolate(void);
		static Colour Coral(void);
		static Colour CornflowerBlue(void);
		static Colour Cornsilk(void);
		static Colour Crimson(void);
		static Colour Cyan(void);
		static Colour DarkBlue(void);
		static Colour DarkCyan(void);
		static Colour DarkGoldenrod(void);
		static Colour DarkGray(void);
		static Colour DarkGreen(void);
		static Colour Green(void);
		static Colour GreenYellow(void);
		static Colour Honeydew(void);
		static Colour HotPink(void);
		static Colour IndianRed(void);
		static Colour Indigo(void);
		static Colour Ivory(void);
		static Colour Khaki(void);
		static Colour Lavender(void);
		static Colour LavenderBlush(void);
		static Colour LawnGreen(void);
		static Colour LemonChiffon(void);
		static Colour LightBlue(void);
		static Colour LightCoral(void);
		static Colour LightCyan(void);
		static Colour LightGoldenrodYellow(void);
		static Colour LightGreen(void);
		static Colour LightGray(void);
		static Colour LightPink(void);
		static Colour LightSalmon(void);
		static Colour LightSeaGreen(void);
		static Colour LightSkyBlue(void);
		static Colour LightSlateBlue(void);
		static Colour LightSteelBlue(void);
		static Colour LightYellow(void);
		static Colour Lime(void);
		static Colour LimeGreen(void);
		static Colour Linen(void);
		static Colour Magenta(void);
		static Colour Maroon(void);
		static Colour MediumAquamarine(void);
		static Colour MediumBlue(void);
		static Colour MediumOrchid(void);
		static Colour MediumPurple(void);
		static Colour MediumSeaGreen(void);
		static Colour MediumSlateBlue(void);
		static Colour MediumSpringGreen(void);
		static Colour MediumTurquoise(void);
		static Colour MediumVioletRed(void);
		static Colour MidnightBlue(void);
		static Colour MintCream(void);
		static Colour MistyRose(void);
		static Colour Moccasin(void);
		static Colour NavajoWhite(void);
		static Colour Navy(void);
		static Colour OldLace(void);
		static Colour Olive(void);
		static Colour OliveDrab(void);
		static Colour Orange(void);
		static Colour OrangeRed(void);
		static Colour Orchid(void);
		static Colour PaleGoldenrod(void);
		static Colour PaleGreen(void);
		static Colour PaleTurquoise(void);
		static Colour PaleVioletRed(void);
		static Colour PapayaWhip(void);
		static Colour PeachPuff(void);
		static Colour Peru(void);
		static Colour Pink(void);
		static Colour Plum(void);
		static Colour PowderBlue(void);
		static Colour Purple(void);
		static Colour Red(void);
		static Colour RosyBrown(void);
		static Colour RoyalBlue(void);
		static Colour SaddleBrown(void);
		static Colour Salmon(void);
		static Colour SandyBrown(void);
		static Colour SeaGreen(void);
		static Colour Seashell(void);
		static Colour Sienna(void);
		static Colour Silver(void);
		static Colour SkyBlue(void);
		static Colour SlateBlue(void);
		static Colour SlateGray(void);
		static Colour Snow(void);
		static Colour SpringGreen(void);
		static Colour SteelBlue(void);
		static Colour Tan(void);
		static Colour Teal(void);
		static Colour Thistle(void);
		static Colour Tomato(void);
		static Colour Turquoise(void);
		static Colour Violet(void);
		static Colour Wheat(void);
		static Colour White(void);
		static Colour WhiteSmoke(void);
		static Colour Yellow(void);
		static Colour YellowGreen(void);
/*
		static Colour FromArgb(int32_t a, int32_t r, int32_t g, int32_t b);

		static uint16_t To16bit(Colour c);

		static uint16_t To16bit(int32_t a, int32_t r, int32_t g, int32_t b);*/

};



#endif /* ColourS_HPP */
