roobituk/Blaze/Firmware/Arduino/blaze/Buffered8bppContext.h

#ifndef BUFFERED_8BPP_CONTEXT_H
#define BUFFERED_8BPP_CONTEXT_H

#include "BufferedContext.h"

/*!-----------------------------------------------------------------------------

*/
class Buffered8bppContext : public BufferedContext {


};

#endif
