roobituk/Blaze/Firmware/Arduino/blaze/Common.h

#ifndef COMMON_H
#define COMMON_H

#include <stdlib.h>
#include <stdint.h>
#include <stdio.h>
#include <stdbool.h>
#include <math.h>
#include <string>

//#include <cstdlib>

//#include "WString.h"

#include "Types.h"
#include "Macros.h"

#include "MK22F12.h"

#endif
