roobituk/Blaze/Firmware/Arduino/blaze/Context.cpp

#include "Context.h"

// -----------------------------------------------------------------------------
Context::Context(void) {

}

// -----------------------------------------------------------------------------
Context::~Context(void) {

}

// -----------------------------------------------------------------------------
int16_t Context::width() const {
	return m_width;
}

// -----------------------------------------------------------------------------
int16_t Context::height() const {
	return m_height;
}

// -----------------------------------------------------------------------------
void Context::setWidth(int16_t width) {
	m_width = width;
}

// -----------------------------------------------------------------------------
void Context::setHeight(int16_t height) {
	m_height = height;
}
