roobituk/Blaze/Firmware/Examples/KDS/4. USB/Sources/grlib/st7789s.h

#ifndef __st7789s_h
#define __st7789s_h

#include "grlib.h"

// register definitions
#define ili9341_reg_no_operation							(0x00)
#define ili9341_reg_software_reset							(0x01)
#define ili9341_reg_read_id									(0x04)
#define ili9341_reg_read_status								(0x09)
#define ili9341_reg_read_power_mode							(0x0A)
#define ili9341_reg_read_madctl								(0x0B)
#define ili9341_reg_read_pixel_format						(0x0C)
#define ili9341_reg_read_image_format						(0x0D)
#define ili9341_reg_read_signal_mode						(0x0E)
#define ili9341_reg_read_diagnostic_result					(0x0F)
#define ili9341_reg_enter_sleep_mode						(0x10)
#define ili9341_reg_sleep_out								(0x11)
#define ili9341_reg_partial_mode_on							(0x12)
#define ili9341_reg_normal_display_mode_on					(0x13)
#define ili9341_reg_display_inversion_off					(0x20)
#define ili9341_reg_display_inversion_on					(0x21)
#define ili9341_reg_gamma_set								(0x26)
#define ili9341_reg_display_off								(0x28)
#define ili9341_reg_display_on								(0x29)
#define ili9341_reg_column_address_set						(0x2A)
#define ili9341_reg_page_address_set						(0x2B)
#define ili9341_reg_memory_write							(0x2C)
#define ili9341_reg_color_set								(0x2D)
#define ili9341_reg_memory_read								(0x2E)
#define ili9341_reg_partial_area							(0x30)
#define ili9341_reg_vertical_scroll_definition				(0x33)
#define ili9341_reg_tearing_effect_off						(0x34)
#define ili9341_reg_tearing_effect_on						(0x35)
#define ili9341_reg_memory_access_control					(0x36)
#define ili9341_reg_vertical_scrolling_start_address		(0x37)
#define ili9341_reg_idle_mode_off							(0x38)
#define ili9341_reg_idle_mode_on							(0x39)
#define ili9341_reg_pixel_format_set						(0x3A)
#define ili9341_reg_write_memory_continue					(0x3C)
#define ili9341_reg_read_memory_continue					(0x3E)
#define ili9341_reg_set_tear_scanline						(0x44)
#define ili9341_reg_get_scanline							(0x45)
#define ili9341_reg_write_display_brightness				(0x51)
#define ili9341_reg_read_display_brightness					(0x52)
#define ili9341_reg_write_ctrl_display						(0x53)
#define ili9341_reg_read_ctrl_display						(0x54)
#define ili9341_reg_write_cabc								(0x55)
#define ili9341_reg_read_cabc								(0x56)
#define ili9341_reg_write_cabc_minimum_brightness			(0x5E)
#define ili9341_reg_read_cabc_minimum_brightness			(0x5F)
#define ili9341_reg_rgb_interface_signal_control			(0xB0)
#define ili9341_reg_frame_rate_control_normal				(0xB1)
#define ili9341_reg_frame_rate_control_idle					(0xB2)
#define ili9341_reg_frame_rate_control_partial				(0xB3)
#define ili9341_reg_display_inversion_control				(0xB4)
#define ili9341_reg_blanking_porch_control					(0xB5)
#define ili9341_reg_display_function_control				(0xB6)
#define ili9341_reg_entry_mode_set							(0xB7)
#define ili9341_reg_backlight_control_1						(0xB8)
#define ili9341_reg_backlight_control_2						(0xB9)
#define ili9341_reg_backlight_control_3						(0xBA)
#define ili9341_reg_backlight_control_4						(0xBB)
#define ili9341_reg_backlight_control_5						(0xBC)
#define ili9341_reg_backlight_control_7						(0xBE)
#define ili9341_reg_backlight_control_8						(0xBF)
#define ili9341_reg_power_control_1							(0xC0)
#define ili9341_reg_power_control_2							(0xC1)
#define ili9341_reg_vcom_control_1							(0xC5)
#define ili9341_reg_vcom_control_2							(0xC7)
#define ili9341_reg_nv_memory_write							(0xD0)
#define ili9341_reg_nv_memory_protection_key				(0xD1)
#define ili9341_reg_nv_memory_status_read					(0xD2)
#define ili9341_reg_read_id_4								(0xD3)
#define ili9341_reg_read_id_1								(0xDA)
#define ili9341_reg_read_id_2								(0xDB)
#define ili9341_reg_read_id_3								(0xDC)
#define ili9341_reg_positive_gamma_correction				(0xE0)
#define ili9341_reg_negative_gamma_correction				(0xE1)
#define ili9341_reg_digital_gamma_control_1					(0xE2)
#define ili9341_reg_digital_gamma_control_2					(0xE3)
#define ili9341_reg_interface_control						(0xF6)


// external display interface for the ili9341
extern const lcd_display_t g_st7789s_display;

#endif
