roobituk/Blaze/(commit log)

2016-12-11 Added bootloader drivers
2016-12-11 Added schematic mods
    All Kickstarter rewards were shipped out with the mods applied to the
    boards.
2016-12-11 Updated bills of materials
    [Bill of Materials.xls]
2016-12-11 Updated Bootloader driver readme
2017-03-26 Added Arduino Example
    Added the folders ready for the Arduino IDE examples for Blaze
2017-03-26 Added Arduino Support Package Folder
    Added a folder for the Arduino Support Package installer
2017-05-18 Initial Blaze Arduino Core
    This is a very early release of the Blaze Arduino code. A number of
    basic Arduino API functions are available as well as primitive graphics
    support
